Nitrokey/nitrokey-trng-rs232-hardware/trng-serial.jpg

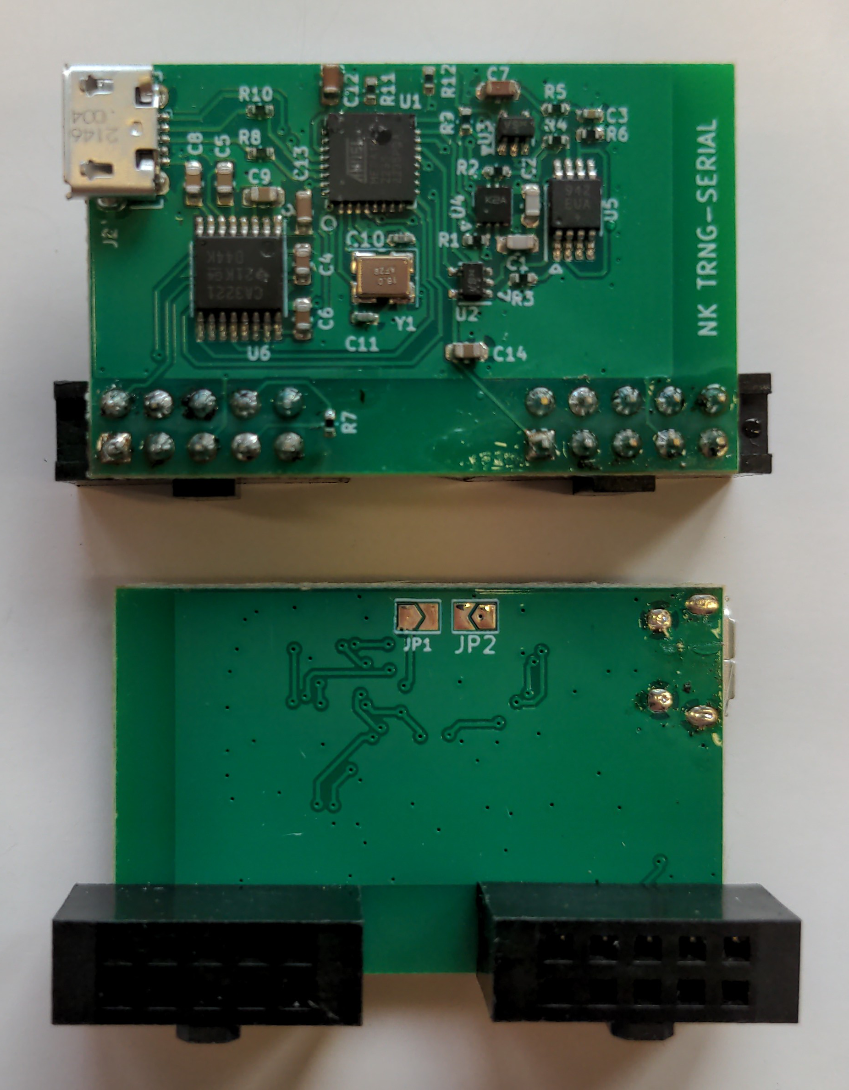
trng-serial.jpg
