Nitrokey/nitrokey-trng-rs232-hardware/trng-serial-bom.xlsx

BOM Version: 5 | Nitrokey TRNG RS232 - Tartaros | 2025-09-26
RD | Value | Footprint | Quantity | Manufacturer | MPN | URL | Alternative
> C1, C2 | 220p 50V 5% C0G | Capacitor_SMD:C_0603_1608Metric | 2 | Murata | GRM1885C1H221JA01D | https://www.digikey.de/en/products/detail/GRM1885C1H221JA01D/490-1435-1-ND/587673?curr=usd
C3 | 22n | Capacitor_SMD:C_0402_1005Metric | 1
> C4, C6 | 100n 25V X5R | Capacitor_SMD:C_0603_1608Metric | 2
> C5, C8, C9, C14 | 0.47u 25V X7R | Capacitor_SMD:C_0603_1608Metric | 4
> C7, C12, C13 | 4.7u 25V X7R | Capacitor_SMD:C_0603_1608Metric | 3
> C10, C11 | 18pF C0G | Capacitor_SMD:C_0402_1005Metric | 2
J2 | USB_B_Micro | Connector_USB:USB_Micro-B_Molex-105017-0001 | 1 | Molex | 1050170001 | https://www.digikey.de/de/products/detail/molex/1050170001/2350832
J1 | SFH11-PBPC-D05-ST-BK | Connector_PinSocket_2.54mm:PinSocket_2x05_P2.54mm_Vertical | 1 | Sullins | SFH11-PBPC-D05-ST-BK | https://www.digikey.de/de/products/detail/sullins-connector-solutions/SFH11-PBPC-D05-ST-BK/1990087
J3 | DNP |  | 0
> R1, R2 | 8.2K 1% | Resistor_SMD:R_0402_1005Metric | 2
> R3-R6, R9, R11, R12 | 10K 1% | Resistor_SMD:R_0402_1005Metric | 7
R7 | 0R | Resistor_SMD:R_0402_1005Metric | 1
> R8, R10 | 27R 1% | Resistor_SMD:R_0402_1005Metric | 2
U1 | ATmega16U2-M | Package_DFN_QFN:QFN-32-1EP_5x5mm_P0.5mm_EP3.1x3.1mm | 1 | Microchip | ATmega16U2-M | https://www.mouser.de/ProductDetail/Microchip-Technology-Atmel/ATMEGA16U2-MU?qs=JV7lzlMm3yIZlyznMyuPNA%3D%3D
> U2, U3 | 74HCT1G66GW,125 | Package_TO_SOT_SMD:SOT-353_SC-70-5 | 2 | Nexperia | 74HCT1G66GW,125 | https://www.digikey.de/short/f9nwvdrf
U4 | TSV912IQ2T | Package_DFN_QFN:DFN-8-1EP_2x2mm_P0.5mm_EP1.05x1.75mm | 1 | ST | TSV912IQ2T | https://de.farnell.com/stmicroelectronics/tsv912iq2t/op-verst-rker-8mhz-4-5v-us-dfn/dp/2762662
U5 | TS3022IYST | Package_SO:MSOP-8_3x3mm_P0.65mm | 1 | ST | TS3022IYST | https://www.digikey.de/en/products/detail/stmicroelectronics/TS3022IYST/8321879 | TC75W57FU
U6 | SN75C3221PWR | Package_SO:TSSOP-16_4.4x5mm_P0.65mm | 1 | TI | SN75C3221PWR | https://www.digikey.de/de/products/detail/texas-instruments/SN75C3221PWR/484694
Y1 | ABM8-16.000MHZ-B2-T | Crystal:Crystal_SMD_3225-4Pin_3.2x2.5mm | 1 | Abracon | ABM8-16.000MHZ-B2-T | https://www.digikey.de/de/products/detail/abracon-llc/ABM8-16-000MHZ-B2-T/675329
