Nitrokey/nitrokey-trng-rs232-hardware/trng-serial.pdf

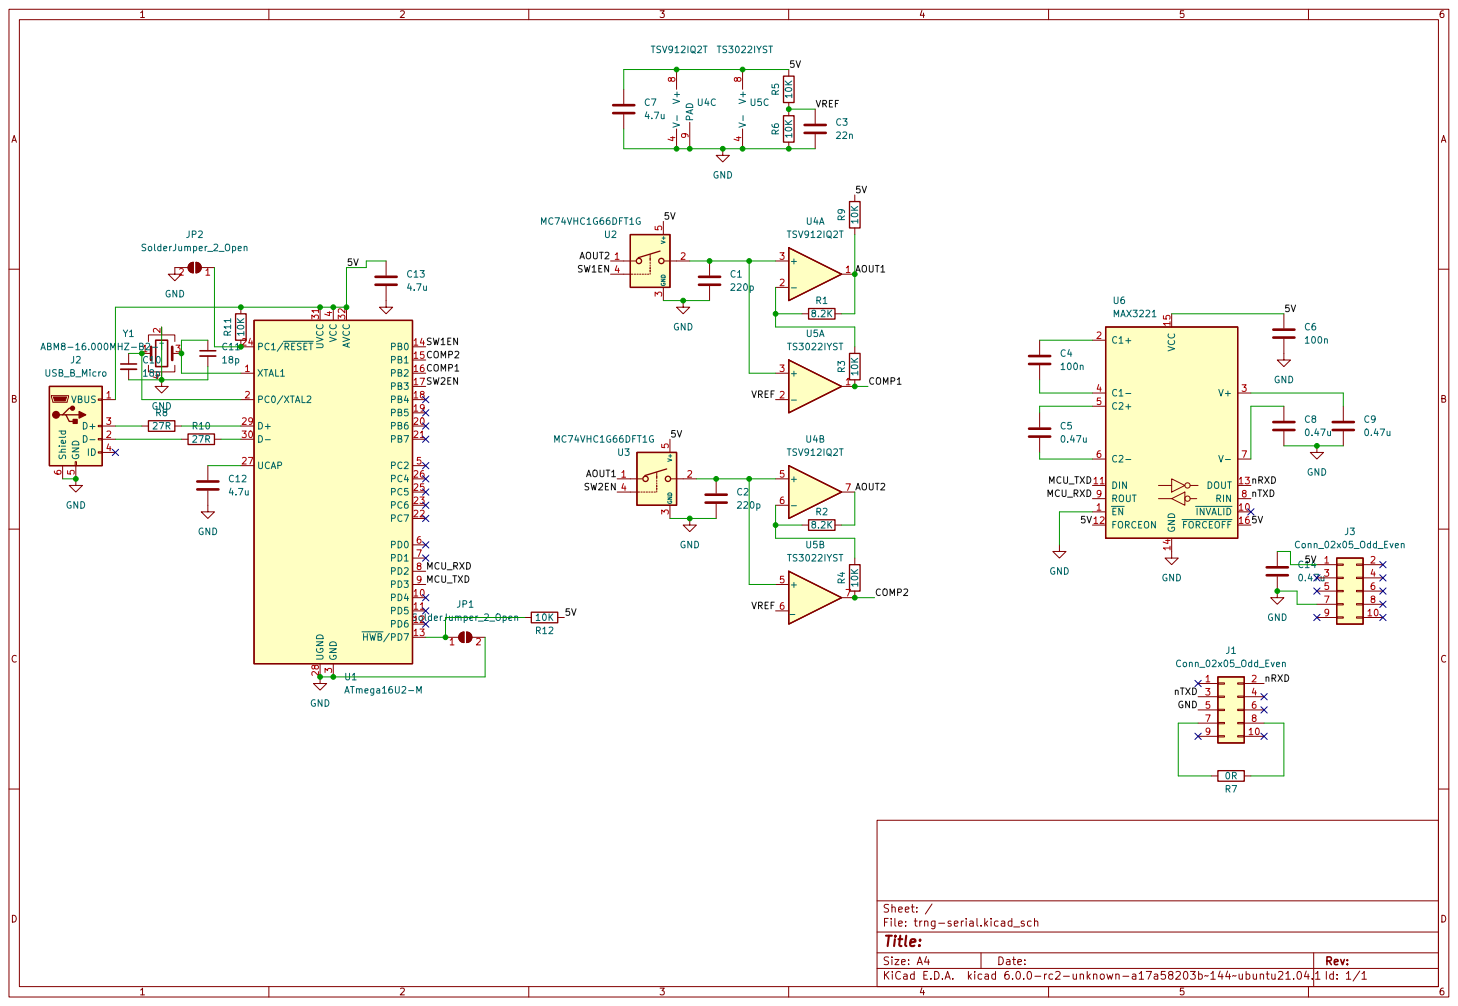
[picture p2: page 1]
