Nitrokey/nitrokey-trng-rs232-hardware/(commit log)

2022-04-14 Fix serial port pinout
    [trng-serial.kicad_pcb, trng-serial.kicad_sch]
2022-06-14 Add gerbers
2022-08-19 BOM: Alternatives TSV7722IQ2T, MAX942EUA+ added
    [trng-serial-bom.xlsx]
2022-11-24 BOM v2, fix
    [trng-serial-bom.xlsx]
2023-01-28 removed alternatives from BOM
    [trng-serial-bom.xlsx]
2023-03-08 BOM: Added TC75W57FU as alternative
    [trng-serial-bom.xlsx]
2025-02-26 BOM don't place J3, alternative for U2, U3
    [trng-serial-bom.xlsx]
2025-04-01 BOM v4: fix C4, C6 to 0603
    [trng-serial-bom.xlsx]
2025-05-12 Re-save in v9 format
    [trng-serial.kicad_pcb, trng-serial.kicad_sch]
2025-09-27 BOM v5: U2, U3: Nexperia 74HCT1G66GW,125
    [trng-serial-bom.xlsx]
